vynguyen1/whack-AR-mole/Plakat.jpeg

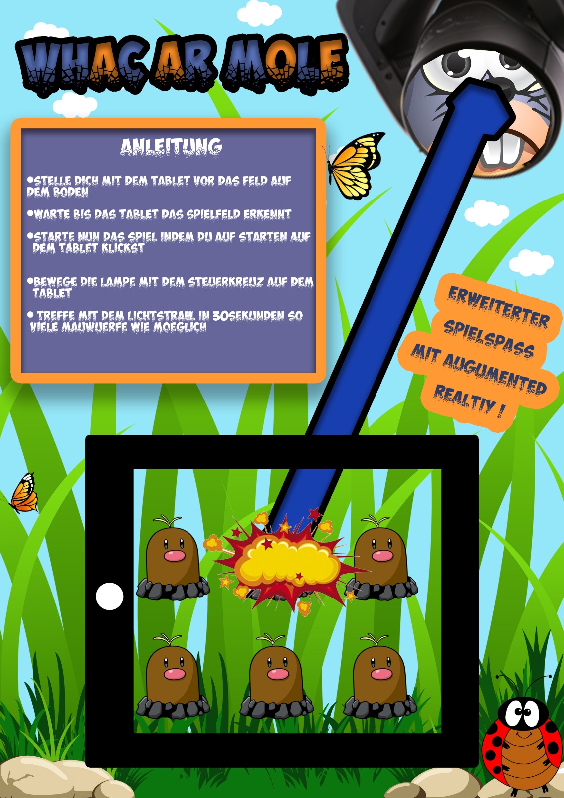
Plakat.jpeg
