vynguyen1/whack-AR-mole/Demo/Demo Bild 1.jpeg

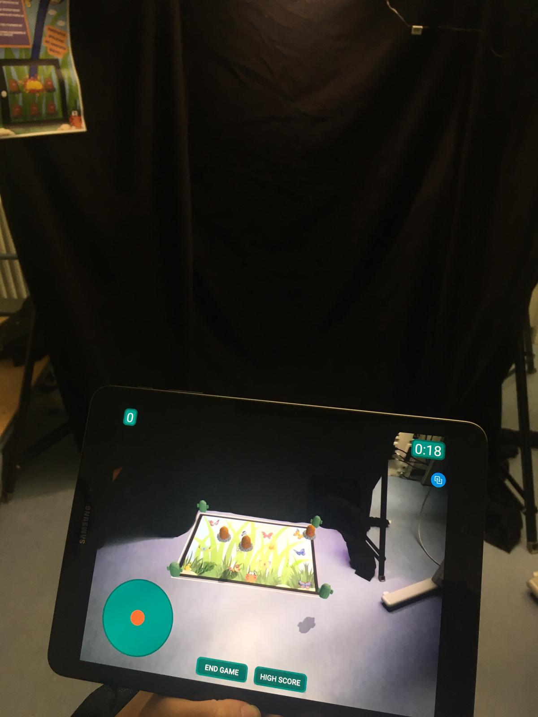
Demo/Demo Bild 1.jpeg
