vynguyen1/whack-AR-mole/README.md

# whack-AR-mole
HAW Hamburg - IT-Systeme/Mobile Systeme bzw. Projekt C SoSe 19 (Medientechnik & Media Systems B.Sc.)
