vynguyen1/whack-AR-mole/Demo/Demo Bild 2.jpeg

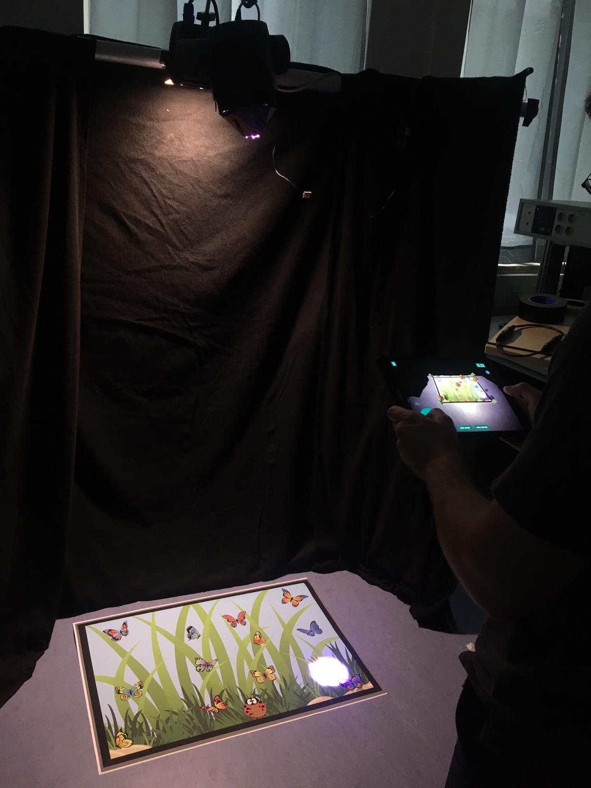
Demo/Demo Bild 2.jpeg
