vynguyen1/whack-AR-mole/Demo/Demo Bild 3.jpeg

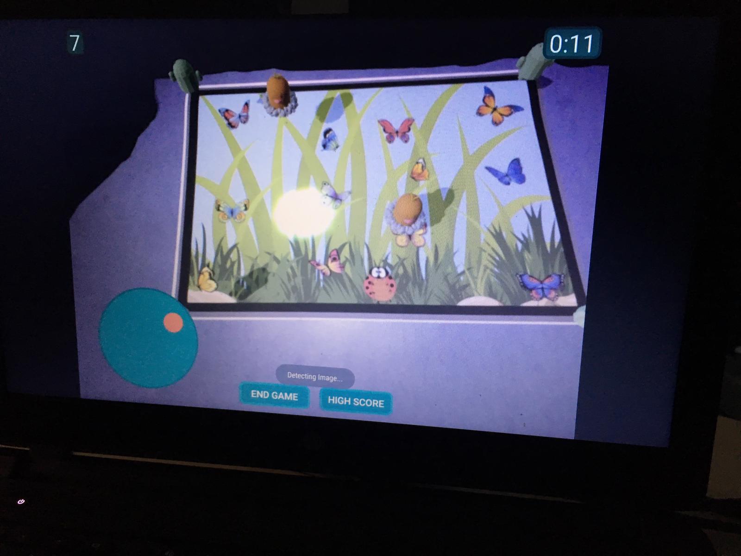
Demo/Demo Bild 3.jpeg
