vynguyen1/whack-AR-mole/MOSY/app/sampledata/models/osoted.obj

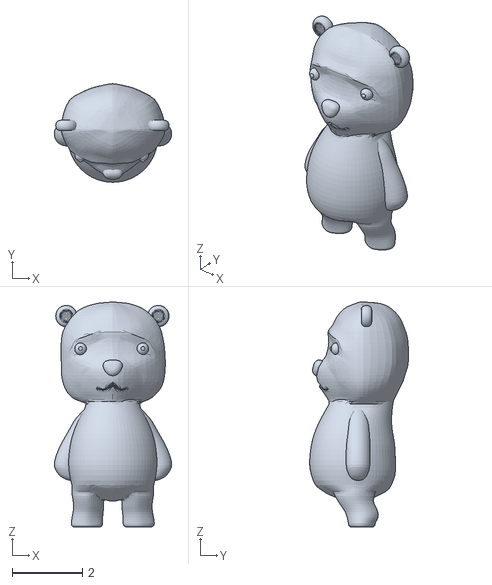
[picture p13: CAD file, 2019-07-18]
MOSY/app/sampledata/models/osoted.obj
3.34 x 2.80 x 6.39
