vynguyen1/whack-AR-mole/(commit log)

2019-07-20 Dokumentation und Demo
2019-07-20 Updated Documentation (Rechtschreib- und Grammatikfehler)
